jingjie-li/EEGAcqSys/README.md

# EEGAcqSys
A EEG acquisition and online processing system based on ADS1299 and TI DSP
