jingjie-li/EEGAcqSys/Thesis/pages/denotation.tex

% multiple1902 <multiple1902@gmail.com>
% denotation.tex
% Copyright 2011~2012, multiple1902 (Weisi Dai)
% https://code.google.com/p/xjtuthesis/
% 
% It is strongly recommended that you read documentations located at
%   http://code.google.com/p/xjtuthesis/wiki/Landing?tm=6
% in advance of your compilation if you have not read them before.
%
% This work may be distributed and/or modified under the
% conditions of the LaTeX Project Public License, either version 1.3
% of this license or (at your option) any later version.
% The latest version of this license is in
%   http://www.latex-project.org/lppl.txt
% and version 1.3 or later is part of all distributions of LaTeX
% version 2005/12/01 or later.
%
% This work has the LPPL maintenance status `maintained'.
% 
% The Current Maintainer of this work is Weisi Dai.
%
\begin{denotation}
   % \iffalse
        \item[EEG]    脑电图
        \item[ADC]    模数转换器
        \item[IIR]    无限单位脉冲响应
        \item[DSP]    数字信号处理
        \item[MCU]    微控制器单元
        \item[PCB]    印制电路板
        \item[SNR]    信噪比
        \item[CCMR]   共模抑制比
        \item[SPI]    串行外围总线？
    %\fi
\end{denotation}
