jingjie-li/EEGAcqSys/Thesis/thesis.tex

% bachelor.tex
% Copyright 2016 Zheng Xie <xie.zheng777@gmail.com>
% https://github.com/Tedxz/xjtuthesis-x
%
% This work may be distributed and/or modified under the
% conditions of the LaTeX Project Public License, either version 1.3
% of this license or (at your option) any later version.
% The latest version of this license is in
%   http://www.latex-project.org/lppl.txt
% and version 1.3 or later is part of all distributions of LaTeX
% version 2005/12/01 or later.
%
% This work has the LPPL maintenance status `maintained'.
%
% The Current Maintainer of this work is Zheng Xie.
%
% xjtuthesis-x is a Derived Work of xjtuthesis. The original maintainer of
% xjtuthesis is Weisi Dai (multiple1902 <multiple1902@gmail.com>),
% who published the project on https://code.google.com/p/xjtuthesis/ (no
% longer accessable). Currently, xjtuthesis is maintained by Aetf, and can
% be accessed on https://github.com/Aetf/xjtuthesis.
%
% xjtuthesis-x includes bug fixes, new features and a user guide.
% For detail, please refer to Readme.md.
%
% If you want to contribute to xjtuthesis-x or become the maintainer of
% xjtuthesis-x, please feel free to contact me.
% !TEX program = xelatex

\documentclass[
    bachelor,
    %bigskip, % sets linespread factor to 1.5
    truefont, % just turn it on when using Windows
    %nofont, % remember to manally set the fonts
    pdflinks,
    %colorlinks,
    %compact,
    ]{xjtuthesis}

\graphicspath{{figures/}}

\begin{document}

    % 请修改 meta.tex 中的论文元信息
    \input{meta.tex}

    \xjtucinfopage
    \xjtueinfopage
    \xjtutoc
    \clearpage

    % 主要符号表，可以没有
    \input{pages/denotation.tex}

    \xjtucontent

        % 绪论
        \input{pages/intro.tex}

        % 第一章
        \input{pages/EEGAcqusitionDesign}

        % 第二章
        \input{pages/EEGProcessingControlDesign}

        % 第三章
        \input{pages/EEGJointSystem}

        \input{pages/EEGHostProgram}

        \input{pages/EEGSystemHardwarePerformance}

        \input{pages/EEGDesignProblemSolution}

        % 结论与展望
        \input{pages/conclusion.tex}

    \xjtuendcontent

    % 将你要引用的文献的 BibTeX 放入 bibliography.bib
    \xjtubib{bibliography}

    \xjtuappendix

        \input{pages/appendice.tex}

    \xjtuendappendix

    \xjtuspchapter{致谢}{致\qquad 谢}

        \input{pages/acknowledgements.tex}

\end{document}
