jingjie-li/EEGAcqSys/Thesis/pages/EEGHostProgram.tex

\chapter{EEG信号实时显示与处理上位机程序设计}

    \section{引言}

    \section{EEG信号实时显示与处理上位机程序整体结构}

    \section{上位机程序数据接收与处理模块设计}

        \subsection{EEG数据在线滤波器设计}

        \subsection{EEG数据在线显示程序设计}

        \subsection{EEG数据在线功率谱分析与频段能量显示程序设计}

        \subsection{上位机程序实时性保证设计}

    \section{上位机程序测试结果}
        
        \subsection{实时性与运算速度测试结果}

        \subsection{信号分辨力测试结果}

    \section{本章小结}
