jingjie-li/EEGAcqSys/Thesis/pages/EEGJointSystem.tex

\chapter{EEG单芯片数字处理控制模块与信号采集模块整体系统设计与实现}

    \section{引言}
    \esection{Introduction}

    \section{EEG单芯片数字处理控制模块与信号采集模块整体系统结构}
    \esection{Overall Struceure of the EEG Single-Chip Signal Processing and Signal Acqusition Intergrated System}
    
    \section{EEG单芯片数字处理控制模块与信号采集模块整体系统设计细节与原理}
    \esection{Design Details and Principles of the EEG Single-Chip Signal Processing and Signal Acqusition Intergrated System}

        \subsection{整体系统电源供给设计}
        \esubsection{Design of the Power Supply in the Intergrated System}

        \subsection{整体系统外围电气隔离设计}
        \esubsection{Design of the External Electrical Isolation in the Intergrated System}

        \subsection{整体系统内单芯片模块与EEG信号采集模块接口设计}
        \esubsection{Design of the Interface of the Single-Chip Module and EEG Signal Acqusition Module in the Intergrated System}

        \subsection{整体系统内单芯片与电脑上位机模块接口设计}
        \esubsection{Design of the Interface of the Single-Chip and the Host Computer in the Intergrated System}

    \section{本章小结}
    \esection{Summary}
