jingjie-li/EEGAcqSys/Thesis/pages/EEGProcessingControlDesign.tex

\chapter{EEG信号采集控制与处理数字单芯片模块的设计与实现}
\echapter{Design and Implementation of the EEG Signal Processing and Acqusition Control Sigle-Chip Module}

    \section{引言}
    \esection{Introduction}

    \section{EEG信号采集控制与处理单芯片模块整体结构}
    \esection{Overall Struceure of the EEG Signal Processing and Acqusition Control Sigle-Chip Module}
    
    \section{EEG信号采集控制与处理单芯片模块设计细节与原理}
    \esection{Design Details and Principles of the EEG Signal Processing and Acqusition Control Sigle-Chip Module}
        
        \subsection{单芯片型号选择}
        \esubsection{Selection of the Sigle-Chip}

        \subsection{单芯片外围电源、复位与调试系统设计}
        \esubsection{Design of the External Power Supply, Reset and Debug System of the Single-Chip}

        \subsection{单芯片外围输入输出接口设计}
        \esubsection{Design of the External I/O Interface of the Single-Chip}

        \subsection{单芯片控制软件设计}
        \esubsection{Design of the Controlling Software of the Single-Chip}

    \section{本章小结}
    \esection{Summary}
