jingjie-li/EEGAcqSys/Thesis/pages/intro.tex

% multiple1902 <multiple1902@gmail.com>
% intro.tex
% Copyright 2011~2012, multiple1902 (Weisi Dai)
% https://code.google.com/p/xjtuthesis/
% 
% It is strongly recommended that you read documentations located at
%   http://code.google.com/p/xjtuthesis/wiki/Landing?tm=6
% in advance of your compilation if you have not read them before.
%
% This work may be distributed and/or modified under the
% conditions of the LaTeX Project Public License, either version 1.3
% of this license or (at your option) any later version.
% The latest version of this license is in
%   http://www.latex-project.org/lppl.txt
% and version 1.3 or later is part of all distributions of LaTeX
% version 2005/12/01 or later.
%
% This work has the LPPL maintenance status `maintained'.
% 
% The Current Maintainer of this work is Weisi Dai.
%

\chapter{绪论}
\echapter{Preface}

    \section{研究背景及意义}
    \esection{The first section in the Preface}

    \section{脑电信号监测概述}
    \esection{Another section in the Preface}

        \subsection{脑电信号监测原理}
        \esubsection{Subsection in the Preface}

        \subsection{脑电信号监测的应用}
        \esubsection{Subsection in the Preface}

        \subsection{脑电信号检测装置的研究现状与发展趋势}
        \esubsection{Subsection in the Preface}

            \subsubsection{研究现状}

            \subsubsection{发展趋势}

    \section{本文研究目标}
    \esection{Another section in the Preface}

    \section{论文结构安排}
    \esection{Another section in the Preface}
