jingjie-li/EEGAcqSys/PCB/EEGFrontOnly.png

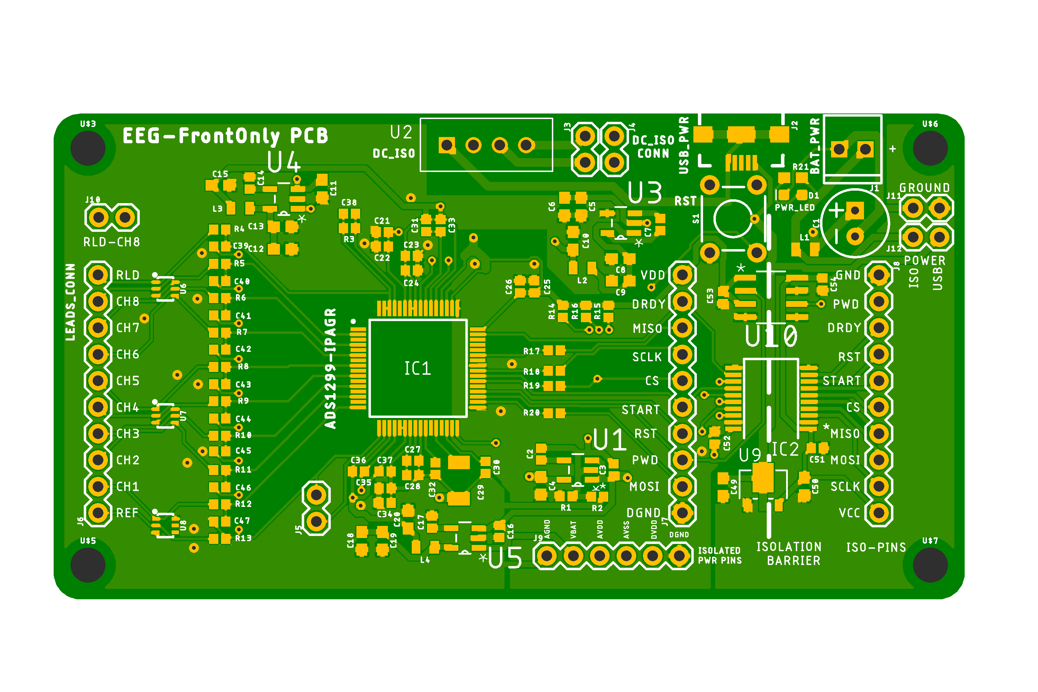
PCB/EEGFrontOnly.png
