jingjie-li/EEGAcqSys/PCB/EEGFrontOnly_bot.png

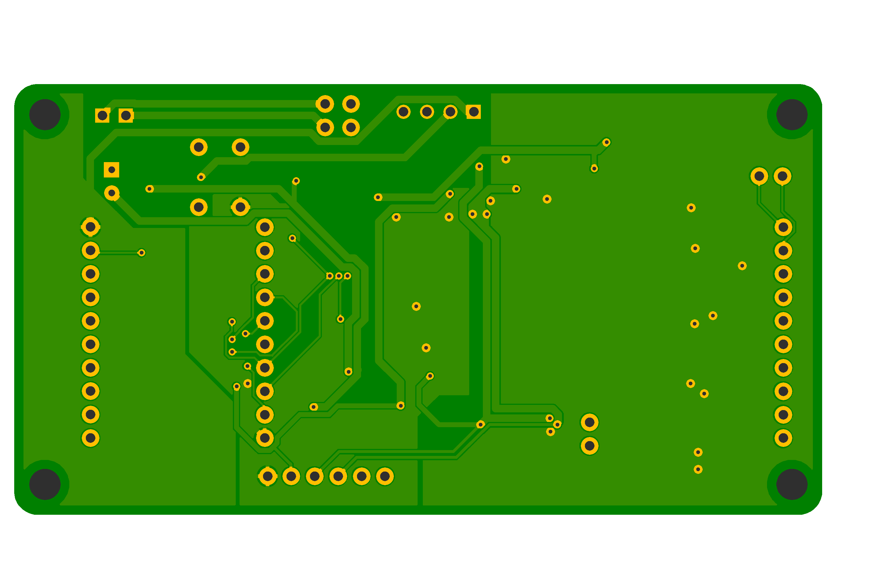
PCB/EEGFrontOnly_bot.png
