jingjie-li/EEGAcqSys/PCB/FullPCB/EEGFull.png

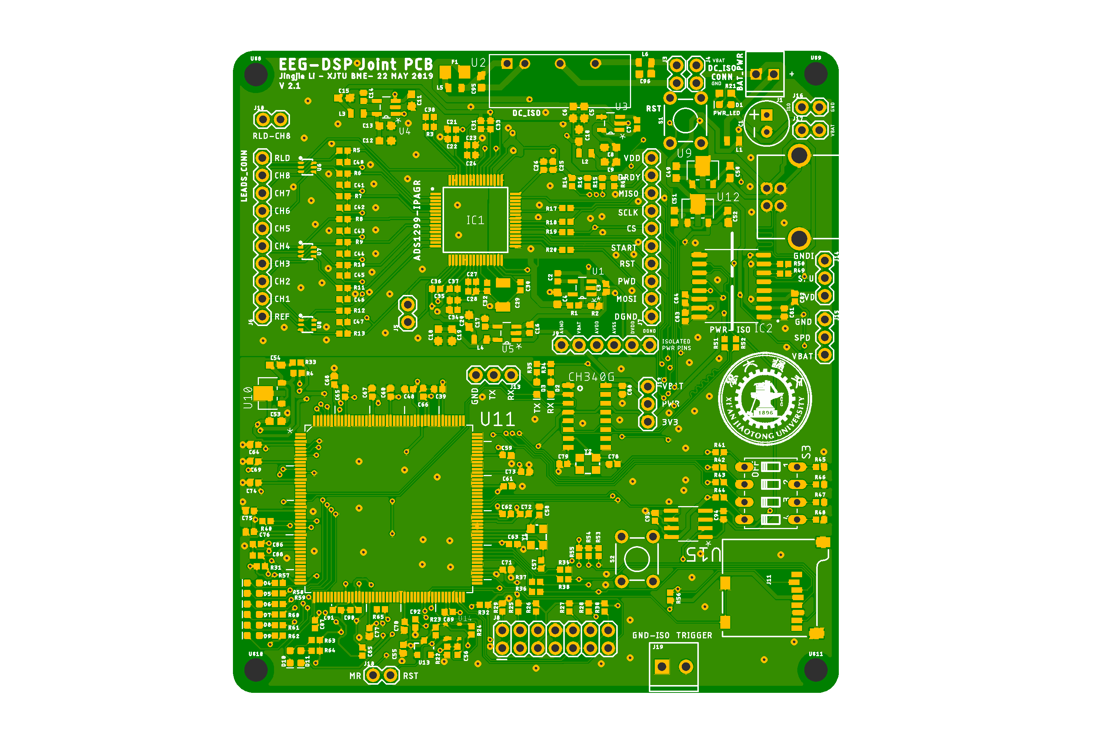
PCB/FullPCB/EEGFull.png
