jingjie-li/EEGAcqSys/PCB/EEGFrontOnly_BOM_Overall_05-10.xlsx

Designator | Description | Comment | Footprint | Pins | Quantity | 编号 | 备注 | 价格
C2,C14 | 贴片电容 | 10NF-0402-50V-10% | 0402 | 2 | 2 | C15195
C3,C7,C16,C17,C21,C23,C25,C30,C31,C32,C34, | 贴片电容 | 1.0UF-0402-16V-10% | 0402 | 2 | 11 | C52923
C4,C11,C12,C19 | 贴片电容 | 2.2UF-0603-10V-20% | 0603 | 2 | 4 | C23630
C5,C8,C10,C13,C15,C18,C20,C49,C50 | 贴片电容 | 10UF-0603-6.3V-20% | 0603 | 2 | 9 | C19702
C6,C9 | 贴片电容 | 1.0UF-0603-16V-10% | 0603 | 2 | 2 | C15849
C22,C24,C26,C27,C33,C35,C53,C54 | 贴片电容 | 0.1UF-0402-16V-10% | 0402 | 2 | 8 | C1525
C28 | 贴片电容 | 10UF-0402-6.3V-20% | 0402 | 2 | 1 | C15525
C29 | 贴片电容 | 100UF-1210-20%-10V | 1206 | 2 | 1 | C15008 | 自己贴 | 1.35
C38 | 贴片电容 | 1.5NF-0402 | 0402 | 2 | 1 | C23967
C40-C47 | 贴片电容 | 4.7NF-0402 | 0402 | 2 | 10 | C1538
C51,C52 | 贴片电容 | 22NF-0402-50V-10% | 0402 | 2 | 2 | C1532
D1 | 红灯 | LED-RED0603 | 0603 | 2 | 1 | C2286 | 换成红色了
L1-L4 | 贴片电感 | 3.3µH/±20%/450mA | 0805 | 2 | 4 | C51725
R1,R2,R4 | 贴片电阻 | 0OHM-0402 | 0402 | 2 | 2 | C17168
R3 | 贴片电阻 | 1M | 0402 | 2 | 1 | C26083
R5-R13 | 贴片电阻 | 4.99K | 0402 | 2 | 10 | C84352
R14-R16 | 贴片电阻 | 10k | 0402 | 2 | 3 | C25744
R17-R20 | 贴片电阻 | 22OHM-0402-1/10W-1% | 0402 | 2 | 4 | C25092
R21 | 贴片电阻 | 2.2KOHM-0603-1/10W-1% | 0603 | 2 | 1 | C4190 |  | 27.15
U1 | LDO | LP2985-33DBVT | SOT-23-5 | 5 | 1 | C75216 |  | 6.67
U3 | DC-DC | TPS60403DBVR | SOT-23-5 | 5 | 1 | C11338 |  | 4.28
U4,U5 | LDO | TPS73225DBVR | SOT-23-5 | 5 | 2 |  | DIGIKEY | 12
U6-U8 | 保护芯片 | TPD4E1B06DCKR | SOT-23-6 | 6 | 3 |  | DIGIKEY | 4.8
U9 | LDO | HT7333 | SOT-89 | 3 | 1 | C84207 |  | 1.09
U10 | 数字隔离器 | ISO721D | SOIC-8_150mil |  | 1 | C189193 | DIGIKEY | 27.78
IC1 | 脑电前端芯片 | ADS1299IPAGR | QFP50P1200X1200X120-64N |  | 1 |  | 已经有了 | 296.5
IC2 | SPI隔离器 | ADUM3151ARSZ | SSOP20 |  | 1 |  | DIGIKEY | 45.6
C1 | 直插电容 | 100uF-2.5MM-6.5MM |  | 2 | 1 |  |  | 1.73
U2 | DC-DC隔离 | B-0505-S | DIP-4 |  | 1 |  |  | 6.11
S1 | 按键开关 |  | 6*6*5 |  | 1 |  |  | 0.5
J1 | 电池插座 | XH2.54-2P | XH2.54-2P |  | 1 |  |  | 2.56
J2 | MircoUSB母座 |  |  |  | 1 |  |  | 0.5
J3-J12 | 排针 |  |  |  |  |  |  | 0.5
 |  |  |  |  |  |  |  | 439.12
