jingjie-li/EEGAcqSys/Thesis/pages/EEGSystemHardwarePerformance.tex

\chapter{硬件系统性能测试及结果分析}
\echapter{Performance and Results of the EEG Hardware System}

    \section{引言}
    \esection{Introduction}

    \section{物理特性}
    \esection{Physical Characteristics}

    \section{电气特性测试}
    \esection{Electrical Characteristics}

        \subsection{脑电前端模拟滤波器频率特性}
        \esubsection{Frequency Characteristics of the EEG Front Analog Filter}

        \subsection{脑电采集系统整体频率特性}
        \esubsection{Frequency Characteristics of the Overall EEG Acqusition System}

        \subsection{脑电采集系统共模抑制比以及信噪比特性}
        \esubsection{CCMR and SNR Characteristics of the Overall EEG Acqusition System}

        \subsection{人体信号测试结果？}
        \esubsection{Human Body Testing Results}

        \subsection{系统功耗测试}
        \esubsection{System Power Consumption}

    \section{本章小结}
    \esection{Summary}
