jingjie-li/EEGAcqSys/Thesis/pages/EEGDesignProblemSolution.tex

\chapter{脑电系统设计过程中的遇到的问题及其解决}
\echapter{Problem Encountered During the Designing of the EEG System and Solution}

    \section{引言}
    \esection{Introduction}

    \section{硬件问题及其解决}
    \esection{Problem and Solution of the Hardware Problems}
        \subsection{SPI总线读取数据不稳定且数值与理想值不符}
        \esubsection{Data Unstable and not Matched with Ideal Data in the SPI BUS}

        \subsection{可检测信号发生器信号但无法检测人体信号}
        \esubsection{Workable with Signals from Digital Signal Generator but not Human Body}

        \subsection{DSP芯片工作不正常，持续复位}
        \esubsection{DSP Signle-Chip Reset Continuously}

        \subsection{USB隔离芯片工作不正常}
        \esubsection{USB Isolation Chip Abnormal}

    \section{软件问题及其解决}
    \esection{Problem and Solution of the Software Problems}
        \subsection{单片机SPI接收数据可以单步调试运行，但是连续运行会出错}
        \esubsection{Single-Chip Can Receive SPI data in Single-step Debugging Mode but not in the Continuous Running Mode}

        \subsection{波形显示程序对电脑性能需求过大}
        \esubsection{Extensive Power Consumption of the Waveform Displaying Software}

        \subsection{方波测试信号中大量毛刺状噪音}
        \esubsection{Spike-like Noise Observed During Square-Wave Signal Testing}

        \subsection{波形显示实时性不佳}
        \esubsection{Poor Realtime Performance of the Waveform Displaying Software}

    \section{本章小结}
    \esection{Summary}
