jingjie-li/EEGAcqSys/PCB/FullPCB/EEGFull.brd

## EAGLE design PCB/FullPCB/EEGFull.brd (2019-05-22)

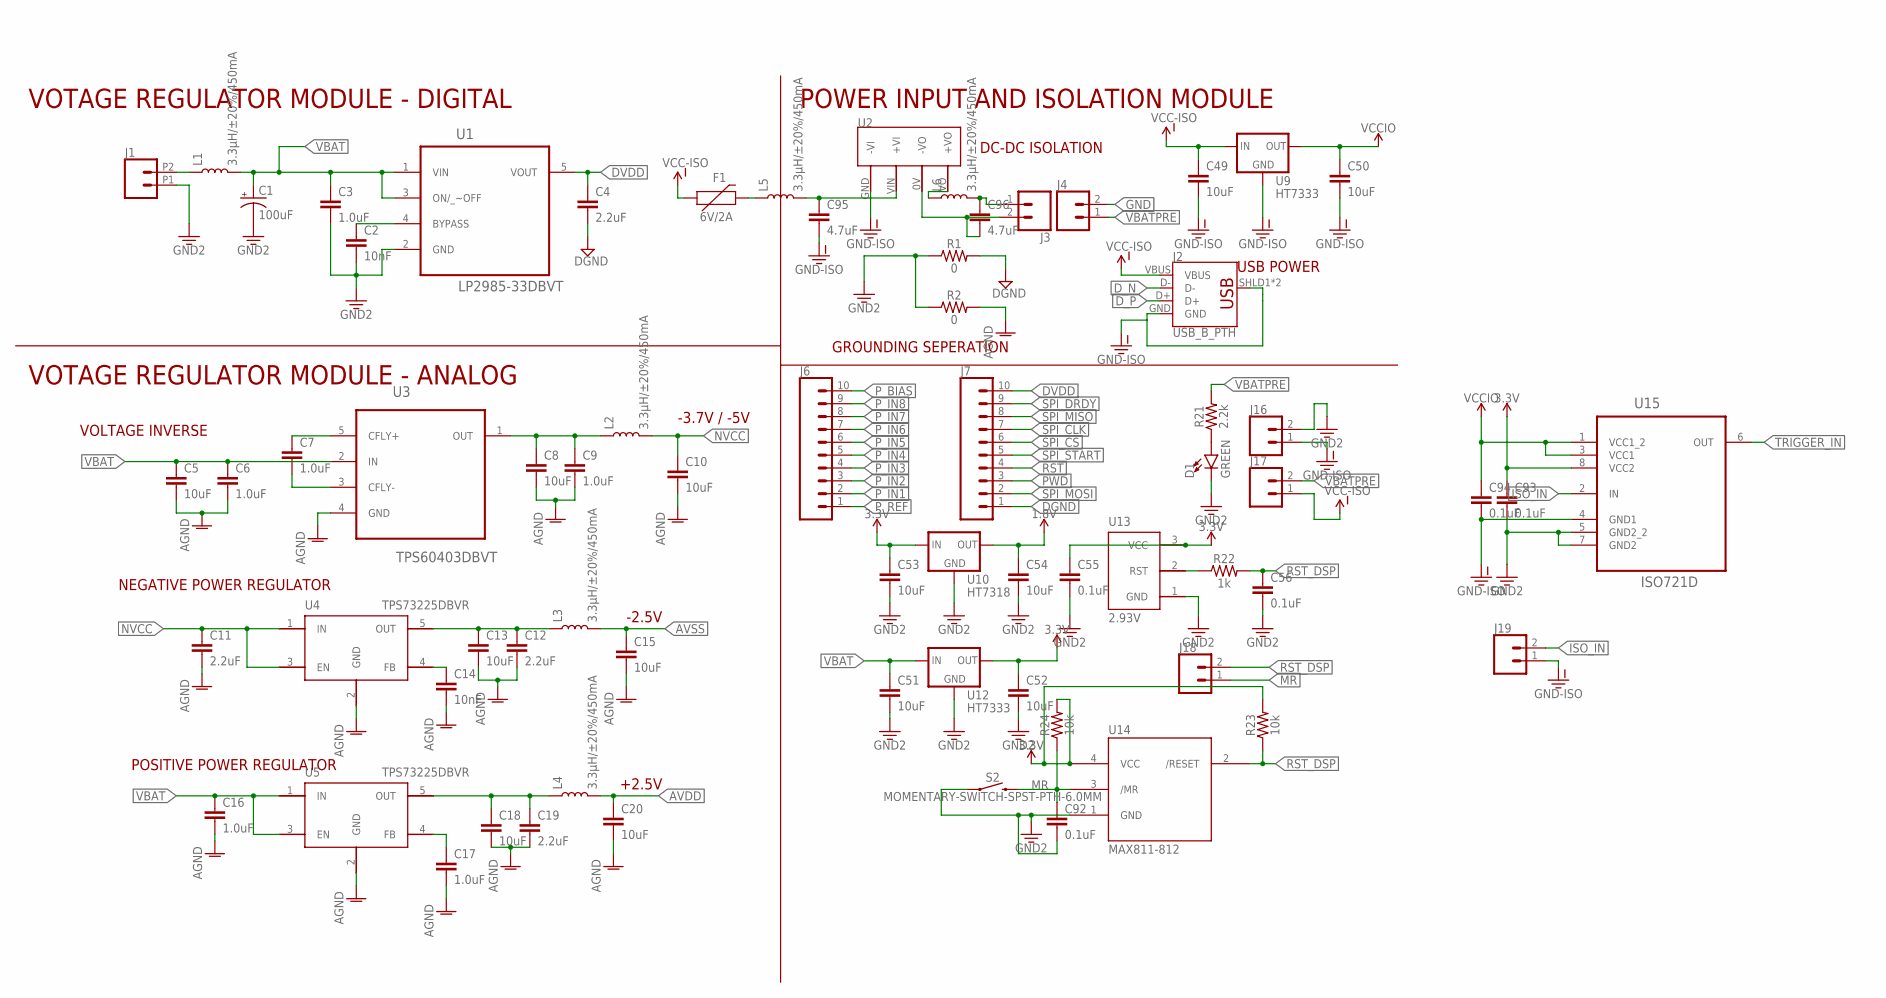
[picture p4: schematic EEGFull.sch, sheet 1]

Parts:
C1: 100uF; CPOL-RADIAL-2.5MM-6.5MM
C2, C14: 10nF; 0402
C3, C7, C16, C17: 1.0uF; 0402
C4, C11, C12, C19: 2.2uF; 0603
C5, C8, C10, C13, C15, C18, C20, C49, C50, C51, C52, C53, C54: 10uF; 0603
C6, C9: 1.0uF; 0603
C55, C56, C92, C93, C94: 0.1uF; 0402
C95, C96: 4.7uF; 0603
D1: GREEN; LED-0603
F1: 6V/2A; 1206
J1: CONN_022.54MM_SCREWTERM; 1X02_2.54_SCREWTERM
J2: USB_B_PTH; USB-B-PTH
J3, J4, J16, J17, J18: CONN_02; 1X02
J6, J7: CONN_10"; 1X10
J19: CONN_023.5MM; SCREWTERMINAL-3.5MM-2
L1, L2, L3, L4, L5, L6: 3.3µH/±20%/450mA; 0805
R1, R2: 0; 0402
R21: 2.2k; 0603
R22: 1k; 0402
R23, R24: 10k; 0402
S2: MOMENTARY-SWITCH-SPST-PTH-6.0MM; TACTILE_SWITCH_PTH_6.0MM
U1: LP2985-33DBVT; SOT95P280X145-5N
U2: B0505S-2W-SIP; SIP
U3: TPS60403DBVT; SOT95P280X145-5N
U4, U5: TPS73225DBVR; SOT95P280X145-5N
U9, U12: HT7333; SOT-89
U10: HT7318; SOT-89
U13: 2.93V; SOT23-3
U14: MAX811-812; SOT143
U15: ISO721D; SOIC127P600X175-8N

Connections:
1.8V: C54.1, U10.1 (OUT); also elsewhere on the board
3.3V: C52.1, C53.1, C55.1, C93.1, R23.2, R24.2, U10.3 (IN), U10.4 (IN), U12.1 (OUT), U13.3 (VCC), U14.4 (VCC), U15.8 (VCC2); also elsewhere on the board
AGND: C5.2, C6.2, C8.2, C9.2, C10.2, C11.2, C12.2, C13.2, C14.2, C15.2, C16.2, C17.2, C18.2, C19.2, C20.2, R2.2, U3.4 (GND), U4.2 (GND), U5.2 (GND); also elsewhere on the board
AVDD: C20.1, L4.2; also elsewhere on the board
AVSS: C15.1, L3.2; also elsewhere on the board
BYPASS: C2.1, U1.4 (BYPASS)
DGND: C4.2, J7.1, R1.2; also elsewhere on the board
DVDD: C4.1, J7.10, U1.5 (VOUT); also elsewhere on the board
D_N: J2.D-; also elsewhere on the board
D_P: J2.D+; also elsewhere on the board
GND: C1.2 (-), C2.2, C3.2, C51.2, C52.2, C53.2, C54.2, C55.2, C56.2, C92.2, C93.2, D1.C, J1.P1 (1), J4.2, J16.2, R1.1, R2.1, S2.1, U1.2 (GND), U10.2 (GND), U12.2 (GND), U13.1 (GND), U14.1 (GND), U15.5 (GND2_2), U15.7 (GND2); also elsewhere on the board
GND-ISO: C49.2, C50.2, C94.2, C95.2, J2.GND, J2.SHLD1 (SHIELD), J2.SHLD2 (SHIELD), J16.1, J19.1, U2.GND (-VI), U9.2 (GND), U15.4 (GND1); also elsewhere on the board
ISO_IN: J19.2, U15.2 (IN)
MR: C92.1, J18.1, R24.1, S2.3 (2), U14.3 (/MR)
unnamed: C96.1, J3.1, L6.2
unnamed: C96.2, J3.2, U2.0V (-VO)
unnamed: C7.1, U3.5 (CFLY+)
unnamed: C7.2, U3.3 (CFLY-)
unnamed: C8.1, C9.1, L2.1, U3.1 (OUT)
unnamed: C17.1, U5.4 (FB)
unnamed: C12.1, C13.1, L3.1, U4.5 (OUT)
unnamed: C14.1, U4.4 (FB)
unnamed: C18.1, C19.1, L4.1, U5.5 (OUT)
unnamed: D1.A, R21.1
unnamed: F1.2, L5.1
unnamed: R22.1, U13.2 (RST)
unnamed: C95.1, L5.2, U2.VIN (+VI)
unnamed: L6.1, U2.VO (+VO)
NVCC: C10.1, C11.1, L2.2, U4.1 (IN), U4.3 (EN)
PWD: J7.3; also elsewhere on the board
P_BIAS: J6.10; also elsewhere on the board
P_IN1: J6.2; also elsewhere on the board
P_IN2: J6.3; also elsewhere on the board
P_IN3: J6.4; also elsewhere on the board
P_IN4: J6.5; also elsewhere on the board
P_IN5: J6.6; also elsewhere on the board
P_IN6: J6.7; also elsewhere on the board
P_IN7: J6.8; also elsewhere on the board
P_IN8: J6.9; also elsewhere on the board
P_REF: J6.1; also elsewhere on the board
RST: J7.4; also elsewhere on the board
RST_DSP: C56.1, J18.2, R22.2, R23.1, U14.2 (/RESET); also elsewhere on the board
SPI_CLK: J7.7; also elsewhere on the board
SPI_CS: J7.6; also elsewhere on the board
SPI_DRDY: J7.9; also elsewhere on the board
SPI_MISO: J7.8; also elsewhere on the board
SPI_MOSI: J7.2; also elsewhere on the board
SPI_START: J7.5; also elsewhere on the board
TRIGGER_IN: U15.6 (OUT); also elsewhere on the board
VBAT: C1.1 (+), C3.1, C5.1, C6.1, C16.1, C51.1, L1.2, U1.1 (VIN), U1.3 (ON/_~OFF), U3.2 (IN), U5.1 (IN), U5.3 (EN), U12.3 (IN), U12.4 (IN); also elsewhere on the board
VBATPRE: J1.P2 (2), J4.1, J17.2, L1.1, R21.2
VCC-ISO: C49.1, F1.1, J2.VBUS, J17.1, U9.3 (IN), U9.4 (IN); also elsewhere on the board
VCCIO: C50.1, C94.1, U9.1 (OUT), U15.1 (VCC1_2), U15.3 (VCC1)

Notes on the sheet:
VOTAGE REGULATOR MODULE - DIGITAL
VOTAGE REGULATOR MODULE - ANALOG
POWER INPUT AND ISOLATION MODULE
VOLTAGE INVERSE
NEGATIVE POWER REGULATOR
POSITIVE POWER REGULATOR
-2.5V
+2.5V
-3.7V / -5V
GROUNDING SEPERATION
USB POWER
DC-DC ISOLATION

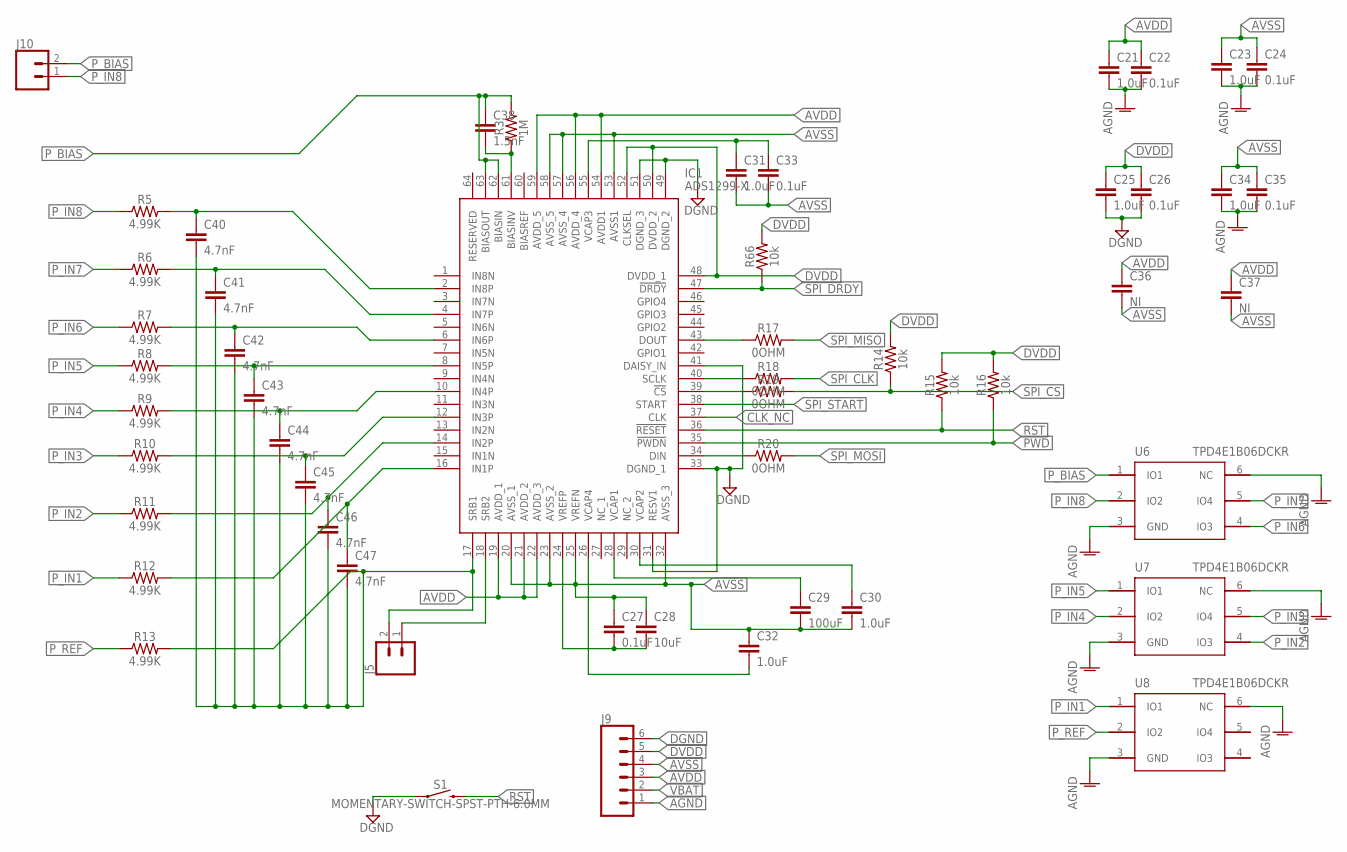
[picture p5: schematic EEGFull.sch, sheet 2]

Parts:
C21, C23, C25, C30, C31, C32, C34: 1.0uF; 0402
C22, C24, C26, C27, C33, C35: 0.1uF; 0402
C28: 10uF; 0402
C29: 100uF; 1210
C36, C37: NI; 0402
C38: 1.5nF; 0402
C40, C41, C42, C43, C44, C45, C46, C47: 4.7nF; 0402
IC1: ADS1299-X; QFP50P1200X1200X120-64N
J5, J10: CONN_02; 1X02
J9: CONN_06SILK_FEMALE_PTH; 1X06
R3: 1M; 0402
R5, R6, R7, R8, R9, R10, R11, R12, R13: 4.99K; 0402
R14, R15, R16, R66: 10k; 0402
R17, R18, R19, R20: 0OHM; 0402
S1: MOMENTARY-SWITCH-SPST-PTH-6.0MM; TACTILE_SWITCH_PTH_6.0MM
U6, U7, U8: TPD4E1B06DCKR; SC70-6

Connections:
AGND: C21.2, C22.2, C23.2, C24.2, C34.2, C35.2, J9.1, U6.3 (GND), U6.6 (NC), U7.3 (GND), U7.6 (NC), U8.3 (GND), U8.6 (NC); also elsewhere on the board
AVDD: C21.1, C22.1, C36.1, C37.1, IC1.19 (AVDD_1), IC1.21 (AVDD_2), IC1.22 (AVDD_3), IC1.54 (AVDD1), IC1.56 (AVDD_4), IC1.59 (AVDD_5), J9.3; also elsewhere on the board
AVSS: C23.1, C24.1, C27.1, C28.1, C29.2, C30.2, C31.2, C32.1, C33.2, C34.1, C35.1, C36.2, C37.2, IC1.20 (AVSS_1), IC1.23 (AVSS_2), IC1.25 (VREFN), IC1.32 (AVSS_3), IC1.53 (AVSS1), IC1.57 (AVSS_4), IC1.58 (AVSS_5), J9.4; also elsewhere on the board
CLK_NC: IC1.37 (CLK)
DGND: C25.2, C26.2, IC1.31 (RESV1), IC1.33 (DGND_1), IC1.41 (DAISY_IN), IC1.49 (DGND_2), IC1.51 (DGND_3), J9.6, S1.1; also elsewhere on the board
DVDD: C25.1, C26.1, IC1.48 (DVDD_1), IC1.50 (DVDD_2), IC1.52 (CLKSEL), J9.5, R14.2, R15.2, R16.2, R66.2; also elsewhere on the board
EEG_REF: C40.2, C41.2, C42.2, C43.2, C44.2, C45.2, C46.2, C47.2, IC1.17 (SRB1), J5.2, R13.2
unnamed: C27.2, C28.2, IC1.24 (VREFP)
unnamed: IC1.18 (SRB2), J5.1
unnamed: C38.2, IC1.61 (BIASINV), R3.1
unnamed: C40.1, IC1.2 (IN8P), R5.2
unnamed: C41.1, IC1.4 (IN7P), R6.2
unnamed: C42.1, IC1.6 (IN6P), R7.2
unnamed: C43.1, IC1.8 (IN5P), R8.2
unnamed: C44.1, IC1.10 (IN4P), R9.2
unnamed: C45.1, IC1.12 (IN3P), R10.2
unnamed: C46.1, IC1.14 (IN2P), R11.2
unnamed: C47.1, IC1.16 (IN1P), R12.2
unnamed: IC1.43 (DOUT), R17.1
unnamed: IC1.40 (SCLK), R18.1
unnamed: IC1.39 (!CS), R19.1
unnamed: IC1.34 (DIN), R20.1
PWD: IC1.35 (!PWDN), R16.1; also elsewhere on the board
P_BIAS: C38.1, IC1.62 (BIASIN), IC1.63 (BIASOUT), J10.2, R3.2, U6.1 (IO1); also elsewhere on the board
P_IN1: R12.1, U8.1 (IO1); also elsewhere on the board
P_IN2: R11.1, U7.4 (IO3); also elsewhere on the board
P_IN3: R10.1, U7.5 (IO4); also elsewhere on the board
P_IN4: R9.1, U7.2 (IO2); also elsewhere on the board
P_IN5: R8.1, U7.1 (IO1); also elsewhere on the board
P_IN6: R7.1, U6.4 (IO3); also elsewhere on the board
P_IN7: R6.1, U6.5 (IO4); also elsewhere on the board
P_IN8: J10.1, R5.1, U6.2 (IO2); also elsewhere on the board
P_REF: R13.1, U8.2 (IO2); also elsewhere on the board
RST: IC1.36 (!RESET), R15.1, S1.3 (2); also elsewhere on the board
SPI_CLK: R18.2; also elsewhere on the board
SPI_CS: R14.1, R19.2; also elsewhere on the board
SPI_DRDY: IC1.47 (!DRDY), R66.1; also elsewhere on the board
SPI_MISO: R17.2; also elsewhere on the board
SPI_MOSI: R20.2; also elsewhere on the board
SPI_START: IC1.38 (START); also elsewhere on the board
VBAT: J9.2; also elsewhere on the board
VCAP1: C29.1, IC1.28 (VCAP1)
VCAP2: C30.1, IC1.30 (VCAP2)
VCAP3: C31.1, C33.1, IC1.55 (VCAP3)
VCAP4: C32.2, IC1.26 (VCAP4)

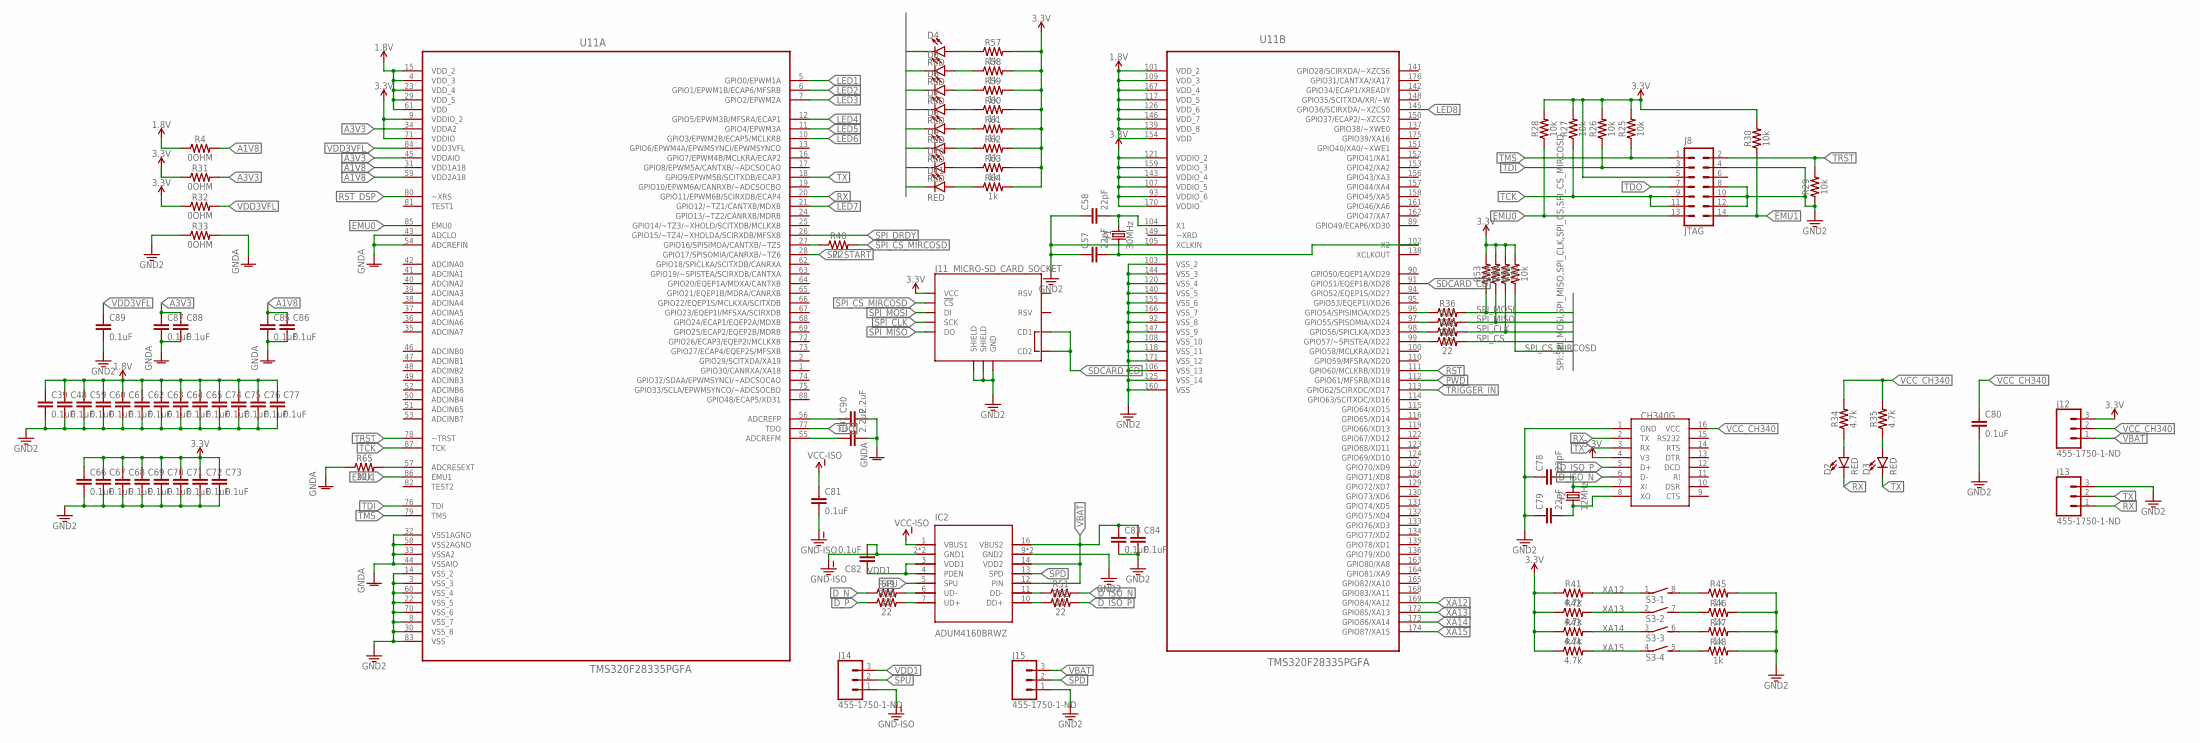
[picture p6: schematic EEGFull.sch, sheet 3]

Parts:
C39, C48, C59, C60, C61, C62, C63, C64, C65, C66, C67, C68, C69, C70, C71, C72, C73, C74, C75, C76, C77, C80, C81, C82, C83, C84, C85, C86, C87, C88, C89: 0.1uF; 0402
C57, C58, C78, C79: 22pF; 0402
C90, C91: 2.2uF; 0402
D2, D3, D4, D5, D6, D7, D8, D9, D10, D11: RED; LED-0603
IC2: ADUM4160BRWZ; SOIC127P1032X265-16N
J8: JTAG; 2X7
J11: MICRO-SD_CARD_SOCKET; MICRO-SD-SOCKET
J12, J13, J14, J15: 455-1750-1-ND; 1X03
R4, R31, R32, R33: 0OHM; 0402
R25, R26, R27, R28, R29, R30, R53, R54, R55, R56: 10k; 0402
R34, R35, R41, R42, R43, R44: 4.7k; 0402
R36, R37, R38, R39, R40, R49, R50, R51, R52: 22; 0402
R45, R46, R47, R48, R57, R58, R59, R60, R61, R62, R63, R64: 1k; 0402
R65: 22k; 0402
S3: DIP04S
U11: TMS320F28335PGFA; QFP50P2600X2600X160-176N
U$3: CH340G; SOIC16
Y1: 30MHz; CRYSTAL-SMD-3.2X2.5MM
Y2: 12MHz; CRYSTAL-SMD-3.2X2.5MM

Connections:
1.8V: C39.1, C48.1, C59.1, C60.1, C61.1, C62.1, C63.1, C64.1, C65.1, C74.1, C75.1, C76.1, C77.1, R4.1, U11.4 (VDD_3), U11.15 (VDD_2), U11.23 (VDD_4), U11.29 (VDD_5), U11.61 (VDD), U11.101 (VDD_2), U11.109 (VDD_3), U11.117 (VDD_5), U11.126 (VDD_6), U11.139 (VDD_8), U11.146 (VDD_7), U11.154 (VDD), U11.167 (VDD_4); also elsewhere on the board
3.3V: C66.1, C67.1, C68.1, C69.1, C70.1, C71.1, C72.1, C73.1, J8.5, J11.VCC, J12.3, R25.2, R26.2, R27.2, R28.2, R30.2, R31.1, R32.1, R41.1, R42.1, R43.1, R44.1, R53.2, R54.2, R55.2, R56.2, R57.2, R58.2, R59.2, R60.2, R61.2, R62.2, R63.2, R64.2, U11.9 (VDDIO_2), U11.71 (VDDIO), U11.93 (VDDIO_6), U11.107 (VDDIO_5), U11.121 (VDDIO_2), U11.143 (VDDIO_4), U11.159 (VDDIO_3), U11.170 (VDDIO), U$3.4 (V3); also elsewhere on the board
A1V8: C85.1, C86.1, R4.2, U11.31 (VDD1A18), U11.59 (VDD2A18)
A3V3: C87.1, C88.1, R31.2, U11.34 (VDDA2), U11.45 (VDDAIO)
D_ISO_N: R51.2, U$3.6 (D-)
D_ISO_P: R52.2, U$3.5 (D+)
D_ISO_PRE_N: IC2.11 (DD-), R51.1
D_ISO_PRE_P: IC2.10 (DD+), R52.1
D_N: R49.1; also elsewhere on the board
D_P: R50.1; also elsewhere on the board
EMU0: J8.13, R28.1, U11.85 (EMU0)
EMU1: J8.14, R30.1, U11.86 (EMU1)
GND: C39.2, C48.2, C57.1, C58.1, C59.2, C60.2, C61.2, C62.2, C63.2, C64.2, C65.2, C66.2, C67.2, C68.2, C69.2, C70.2, C71.2, C72.2, C73.2, C74.2, C75.2, C76.2, C77.2, C78.1, C79.1, C80.2, C83.2, C84.2, C89.2, IC2.9 (GND2), IC2.15 (GND2), J8.4, J8.8, J8.10, J8.12, J11.GND, J11.GND1 (SHIELD), J11.GND3 (SHIELD), J13.3, J15.1, R29.1, R33.1, R45.2, R46.2, R47.2, R48.2, U11.3 (VSS_3), U11.8 (VSS_7), U11.14 (VSS_2), U11.22 (VSS_5), U11.30 (VSS_8), U11.60 (VSS_4), U11.70 (VSS_6), U11.83 (VSS), U11.92 (VSS_8), U11.103 (VSS_2), U11.105 (XCLKIN), U11.106 (VSS_13), U11.108 (VSS_10), U11.118 (VSS_11), U11.120 (VSS_4), U11.125 (VSS_14), U11.140 (VSS_5), U11.144 (VSS_3), U11.147 (VSS_9), U11.155 (VSS_6), U11.160 (VSS), U11.166 (VSS_7), U11.171 (VSS_12), U$3.1 (GND); also elsewhere on the board
GND-ISO: C81.2, C82.2, IC2.2 (GND1), IC2.8 (GND1), J14.1; also elsewhere on the board
GNDA: C85.2, C86.2, C87.2, C88.2, C90.2, C91.2, R33.2, R65.1, U11.32 (VSS1AGND), U11.33 (VSSA2), U11.43 (ADCLO), U11.44 (VSSAIO), U11.54 (ADCREFIN), U11.58 (VSS2AGND)
LED1: D4.C, U11.5 (GPIO0/EPWM1A)
LED2: D5.C, U11.6 (GPIO1/EPWM1B/ECAP6/MFSRB)
LED3: D6.C, U11.7 (GPIO2/EPWM2A)
LED4: D7.C, U11.12 (GPIO5/EPWM3B/MFSRA/ECAP1)
LED5: D8.C, U11.11 (GPIO4/EPWM3A)
LED6: D9.C, U11.10 (GPIO3/EPWM2B/ECAP5/MCLKRB)
LED7: D10.C, U11.21 (GPIO12/~TZ1/CANTXB/MDXB)
LED8: D11.C, U11.145 (GPIO36/SCIRXDA/~XZCS0)
unnamed: C78.2, U$3.7 (XI), Y2.3 (2)
unnamed: C79.2, U$3.8 (XO), Y2.1
unnamed: C58.2, U11.104 (X1), Y1.3 (2)
unnamed: C57.2, U11.102 (X2), Y1.1
unnamed: D11.A, R64.1
unnamed: D2.A, R34.1
unnamed: D3.A, R35.1
unnamed: R36.1, U11.96 (GPIO54/SPISIMOA/XD25)
unnamed: IC2.6 (UD-), R49.2
unnamed: R37.1, U11.97 (GPIO55/SPISOMIA/XD24)
unnamed: R38.1, U11.98 (GPIO56/SPICLKA/XD23)
unnamed: R39.1, U11.99 (GPIO57/~SPISTEA/XD22)
unnamed: R40.1, U11.27 (GPIO16/SPISIMOA/CANTXB/~TZ5)
unnamed: IC2.7 (UD+), R50.2
unnamed: D10.A, R63.1
unnamed: D9.A, R62.1
unnamed: D8.A, R61.1
unnamed: D7.A, R60.1
unnamed: D6.A, R59.1
unnamed: D5.A, R58.1
unnamed: D4.A, R57.1
unnamed: C90.1, U11.56 (ADCREFP)
unnamed: C91.1, U11.55 (ADCREFM)
unnamed: R65.2, U11.57 (ADCRESEXT)
unnamed: R48.1, S3.5 (2)
unnamed: R47.1, S3.6 (2)
unnamed: R46.1, S3.7 (2)
unnamed: R45.1, S3.8 (2)
PWD: U11.112 (GPIO61/MFSRB/XD18); also elsewhere on the board
RST: U11.111 (GPIO60/MCLKRB/XD19); also elsewhere on the board
RST_DSP: U11.80 (~XRS); also elsewhere on the board
RX: D2.C, J13.1, U11.20 (GPIO11/EPWM6B/SCIRXDB/ECAP4), U$3.2 (TX)
SDCARD_CD: J11.CD1, J11.CD2, U11.91 (GPIO51/EQEP1B/XD28)
SPD: IC2.13 (SPD), J15.2
SPI_CLK: J11.SCLK (SCK), R38.2, R55.1; also elsewhere on the board
SPI_CS: R39.2; also elsewhere on the board
SPI_CS_MIRCOSD: J11.CS (!CS), R40.2, R56.1
SPI_DRDY: U11.26 (GPIO15/~TZ4/~XHOLDA/SCIRXDB/MFSXB); also elsewhere on the board
SPI_MISO: J11.DO, R37.2, R54.1; also elsewhere on the board
SPI_MOSI: J11.DI, R36.2, R53.1; also elsewhere on the board
SPI_START: U11.28 (GPIO17/SPISOMIA/CANRXB/~TZ6); also elsewhere on the board
SPU: IC2.5 (SPU), J14.2
TCK: J8.9, J8.11, R27.1, U11.87 (TCK)
TDI: J8.3, R26.1, U11.76 (TDI)
TDO: J8.7, U11.77 (TDO)
TMS: J8.1, R25.1, U11.79 (TMS)
TRIGGER_IN: U11.113 (GPIO62/SCIRXDC/XD17); also elsewhere on the board
TRST: J8.2, R29.2, U11.78 (~TRST)
TX: D3.C, J13.2, U11.18 (GPIO9/EPWM5B/SCITXDB/ECAP3), U$3.3 (RX)
VBAT: C83.1, C84.1, IC2.12 (PIN), IC2.14 (VDD2), IC2.16 (VBUS2), J12.1, J15.3; also elsewhere on the board
VCC-ISO: C81.1, IC2.1 (VBUS1); also elsewhere on the board
VCC_CH340: C80.1, J12.2, R34.2, R35.2, U$3.16 (VCC)
VDD1: C82.1, IC2.3 (VDD1), IC2.4 (PDEN), J14.3
VDD3VFL: C89.1, R32.2, U11.84 (VDD3VFL)
XA12: R41.2, S3.1, U11.169 (GPIO84/XA12)
XA13: R42.2, S3.2 (1), U11.172 (GPIO85/XA13)
XA14: R43.2, S3.3 (1), U11.173 (GPIO86/XA14)
XA15: R44.2, S3.4 (1), U11.174 (GPIO87/XA15)

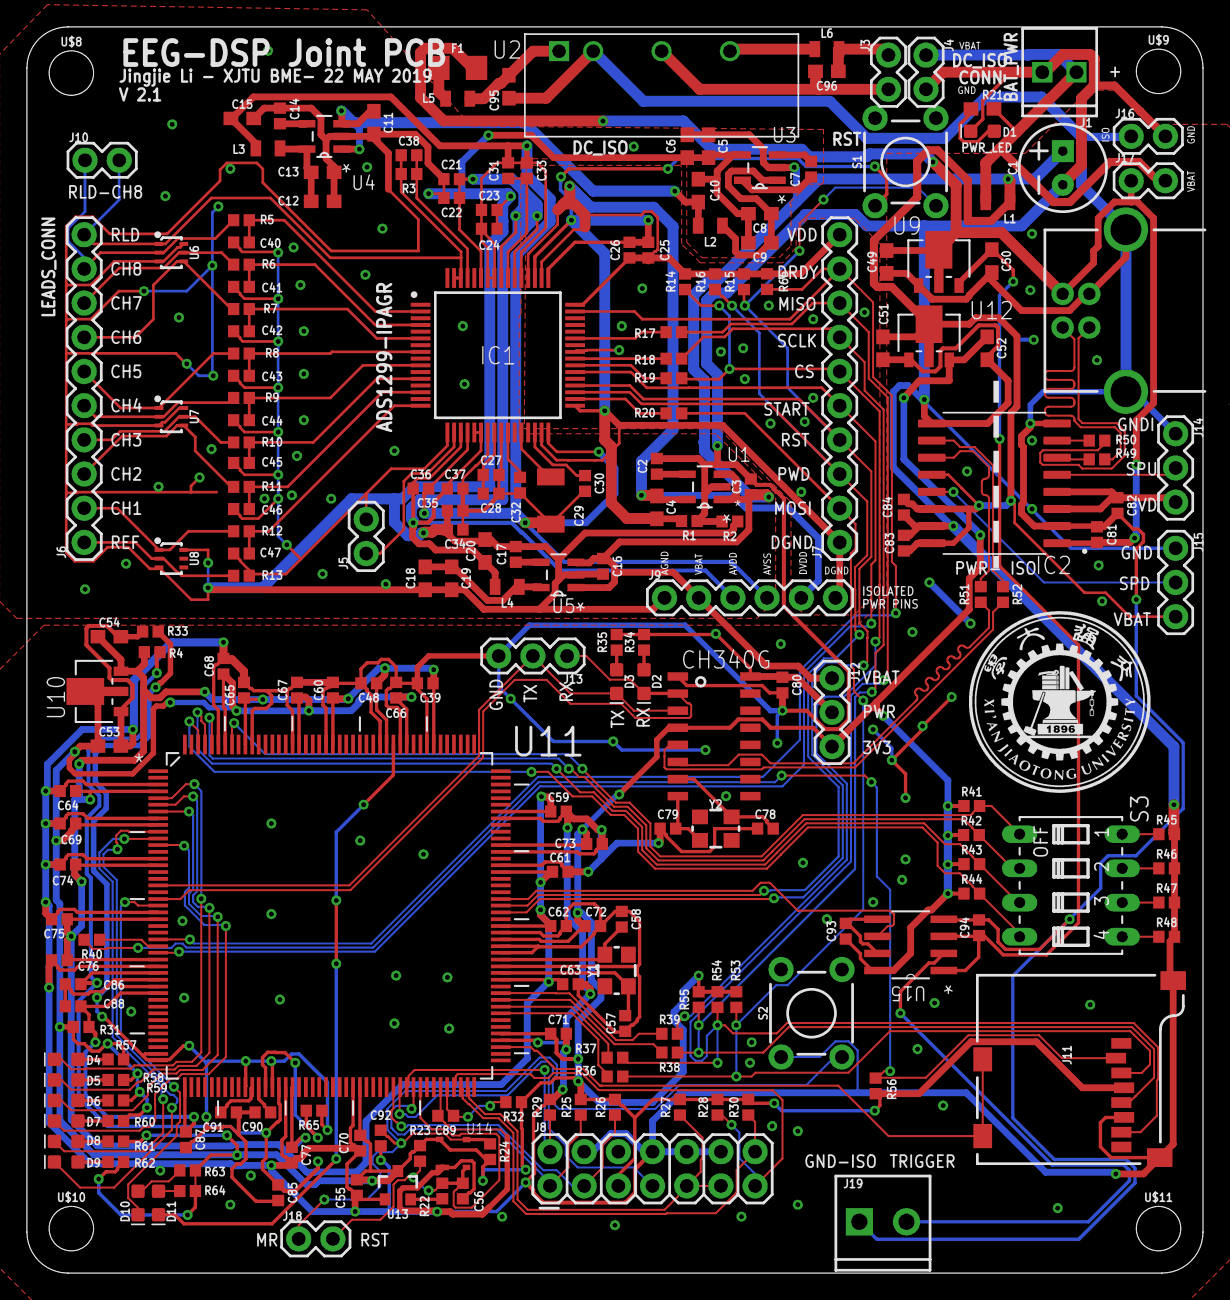
[picture p7: board EEGFull.brd from above]

Board: 2 copper layers, 87.4 x 92.6 mm, 227 parts (0 on the bottom side), 136 nets.

Other parts of the board:
U$7: XJTULOGO
U$8, U$9, U$10, U$11: STAND-OFF
