jingjie-li/EEGAcqSys/GUI/EEGdataRecTest/test/play_back_mode.pde

//  RecordFileSelection File_Behavior_Window;
  
  
  
  
//void setup()
//{
//initialize(feed_back_mode());

//}
  
  
//void initialize_feed_back_mode(){
    
//  loadJSOn();
//  playBackBar = cp5_2.addSlider("").setPosition(0,control_panel_height+window_height)
//     .setSize(14,control_panel_width)
//     .setRange(0,200)
//     .setValue(0);
//  playBackBar.getValueLabel().setText("").setVisible(false);
//  new RecordFileSelection();




//  }
  

  
//class RecordFileSelection extends PApplet {
//  ControlP5 cp5;
//  RecordFileSelection() {
//    super();
//    PApplet.runSketch(new String[] {this.getClass().getSimpleName()}, this);
//    cp5 = new ControlP5(this); 
   
//  }

//  void settings() {
//  size(795,85);
//  cp5.addButton("choose")
//  .setPosition(795-238,303-280)
//  .setSize(238,40);
//  cp5.addButton("select")
//  .setPosition(913-238,303-280)
//  .setSize(100,40);
//  cp5.addTextfield(sketchPath())
//     .setPosition(32,53)
//     .setSize(485,40)
//     .setFont(createFont("arial",20))
//     .setAutoClear(false)
//     ;
//  }

//void draw() {
//  background(color(#C4C4C4));
//}


  

  
//  void exit()
//  {
//    dispose();
//    win = null;
//  }
  

//class chooseButton_ControlListener implements ControlListener{
  
//public void controlEvent(ControlEvent theEvent) {
//    this.getWindow().exit();
//    }
//}
//class selectButton_ControlListner implements ControlListener{
  
//public void controlEvent(ControlEvent theEvent) {
//     selectFolder();
//    }
//}
