jingjie-li/EEGAcqSys/(commit log)

2019-03-20 PCB power parts
    [EEGFrontOnly.brd, EEGFrontOnly.sch]
2019-03-20 ads stuff init
    [EEGFrontOnly.brd, EEGFrontOnly.sch]
2019-03-22 partly complete the ADS part
    [EEGFrontOnly.brd, EEGFrontOnly.sch]
2019-03-23 PCB wiring complete
    [EEGFrontOnly.brd, EEGFrontOnly.sch]
2019-03-24 text adjusting & add power pins and less
    [EEGFrontOnly.brd, EEGFrontOnly.sch]
2019-03-25 front only PCB complete!
    [EEGFrontOnly.brd, EEGFrontOnly.sch]
2019-03-25 ADD gerber, BOM and SMT pos files
    [EEGFrontOnly-smt.csv, EEGFrontOnly.brd, EEGFrontOnly.csv, EEGFrontOnly.sch, EEGFrontOnly_BOM.xlsx, EEGFrontOnly_BOM_Cost_Comp.xlsx]
2019-04-02 ads1299 spi code
2019-04-03 improve SPI reading
2019-04-19 Revert "update guy"
    This reverts commit 80b4e61ff4da07388e47631cd085fe8bc7981739.
    [EEGdataRecTest.pde]
2019-04-19 Revert "Revert "update guy""
    This reverts commit 8ccc27f17946e5c1777cf8efbfd3746bfba457f5.
    [EEGdataRecTest.pde]
2019-04-21 Main BOM
    [EEGFrontOnly_BOM.xlsx]
2019-04-21 cost comp chart
    [EEGFrontOnly_BOM_Cost_Comp.xlsx]
2019-04-24 fix data receiving bug
    [EEGdataRecTest.pde]
2019-04-25 fixed static baseline compute code
    [EEGdataRecTest.pde]
2019-04-27 fix data cannot received bug
    [EEGdataRecTest.pde]
2019-04-28 fix the bug that can not receive the data
    [DataReceiver.pde, FFT_Widget.pde, Timeseries.pde, test.pde]
2019-04-29 Add filter
2019-04-29 fixed the realtime running problem
    [EEGdataRecTest.pde]
2019-04-30 加入了 按x 键退出程序并关停硬件的功能。
2019-05-04 add the band power plot
2019-05-06 add full pub
    [EEGFrontOnly.brd, EEGFrontOnly.sch]
2019-05-06 add funtion to on-off button
2019-05-06 update main pcb
    [EEGFrontOnly.brd, EEGFrontOnly.sch]
2019-05-06 Add stop all button
2019-05-07 add high pass filter
2019-05-07 update pcb & update dsp main code
    [EEGFrontOnly.sch]
2019-05-10 full pcb nearly complete
    [EEGFrontOnly.brd, EEGFrontOnly.sch]
2019-05-12 GND copper cover
    [EEGFrontOnly.brd]
2019-05-22 update EEG ADS PCB
    [EEGFrontOnly-smt-05-10.csv, EEGFrontOnly.brd, EEGFrontOnly.sch, EEGFrontOnly_BOM_Overall_05-10.xlsx]
2019-05-22 update Full PCB
    [EEGFull-smt.csv, EEGFull-smt.xlsx, EEGFull.brd, EEGFull.sch, EEGFull_default_BOM_values.csv, EEGFull_default_BOM_values.xlsx]
